Aedge90/Bierdeckel/presentation/abschussvortrag/vortrag.tex

\documentclass[aspectratio=43,t]{beamer}
%\documentclass[aspectratio=43,t,handout]{beamer}

\usepackage[ansinew]{inputenc}
\usepackage[T1]{fontenc}
\usepackage[english]{babel}
\usepackage{amsmath,amssymb}
\usepackage{graphicx}
\usepackage{listings}
\usepackage{verbatim}
\usepackage[backend=biber,sorting=ydnt,doi=true]{biblatex}
\usepackage{adjustbox}
\usepackage{subfigure}

\usepackage{wrapfig}
\usepackage{chngcntr}
\setbeamertemplate{caption}[numbered]
\usepackage{listings}

\usepackage{amssymb}% http://ctan.org/pkg/amssymb
\usepackage{pifont}% http://ctan.org/pkg/pifont
\newcommand{\cmark}{\ding{51}}%
\newcommand{\xmark}{\ding{55}}%

% Themes:
%  - fau:          Default FAU theme
%  - fau-tf:       TechFak FAU theme
%  - fau-tf-hscd:  Co-Design FAU theme
%
% Options:
%  - seal:         FAU seal on title page (default)
	%  - logo:         Beamer logo on all pages
	%  - image:        Cover image on title page
	%  - plain:        Plain title page
	%  - longtitle:    Title page layout for long title
	%  - dark:         Dark version of theme
	\usetheme[seal, longtitle]{fau-tf}
	%\setbeamercovered{transparent}

	\lstset{%
		language=C++,
			tabsize=2,
			basicstyle=\tt\scriptsize,
			keywordstyle=\color{blue},
			commentstyle=\color{green!50!black},
			stringstyle=\color{black},
			% stringstyle=\color{red},
			numbers=left,
			numbersep=0.5em,
			numberstyle=\tt\tiny
	}

\defbibheading{bibliography}{}
\addbibresource[label=primary]{references.bib}
\nocite{*}

% Title, authors, and date
\title[SmartBierdeggl]{SmartBierdeggl}
\subtitle{DIY: Abschlussvortrag}
\author[Achim Herrmann/Daeubler]{Achim Herrmann/Daeubler}
\institute[Rechnernetze und Kommunikationssysteme]{Rechnernetze und Kommunikationssysteme, Friedrich-Alexander-Universität Erlangen-Nürnberg}
\date{\today}

\begin{document}
% Title
\frame[plain,c,noframenumbering]{\titlepage}

\begin{frame}{Idee}
                \begin{center}
        \begin{adjustbox}{max width=.8\textwidth, max height=.8\textheight}
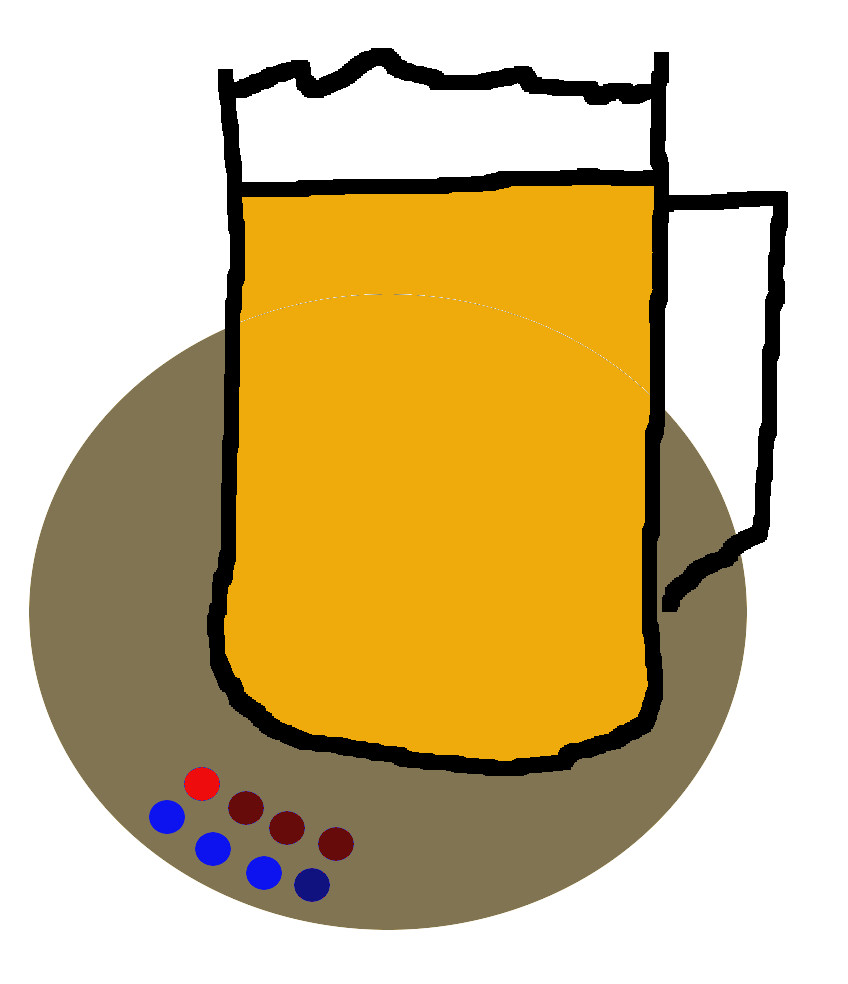
[picture p12: presentation/abschussvortrag/images/idee.jpg]
                        
%        \end{adjustbox}
%        \begin{adjustbox}{max width=.4\textwidth, max height=.4\textheight}
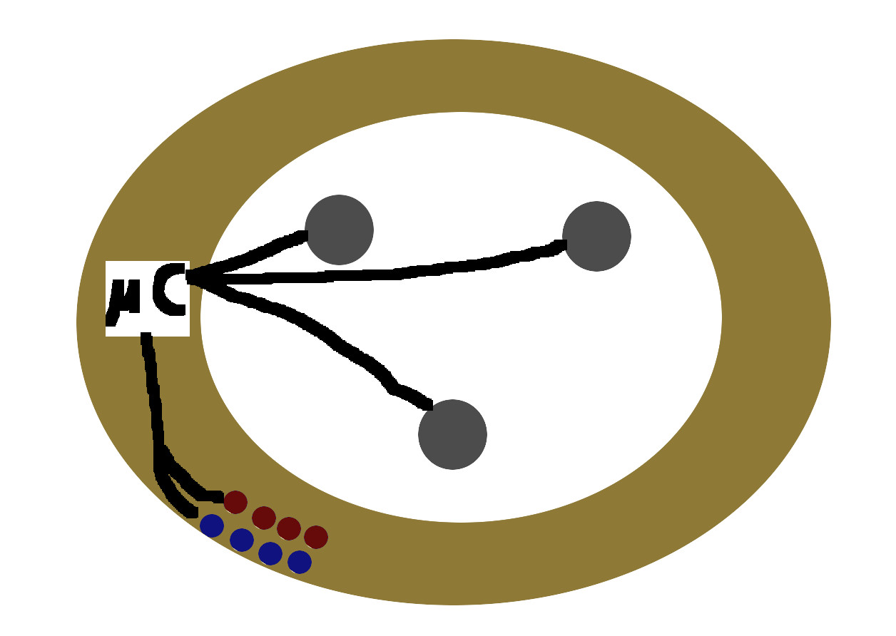
[picture p13: presentation/abschussvortrag/images/aufbau.jpg]
                        
        \end{adjustbox}
                \end{center}
\end{frame}
\begin{frame}{Aktueller Stand}
                \begin{center}
        \begin{adjustbox}{max width=.8\textwidth, max height=.8\textheight}
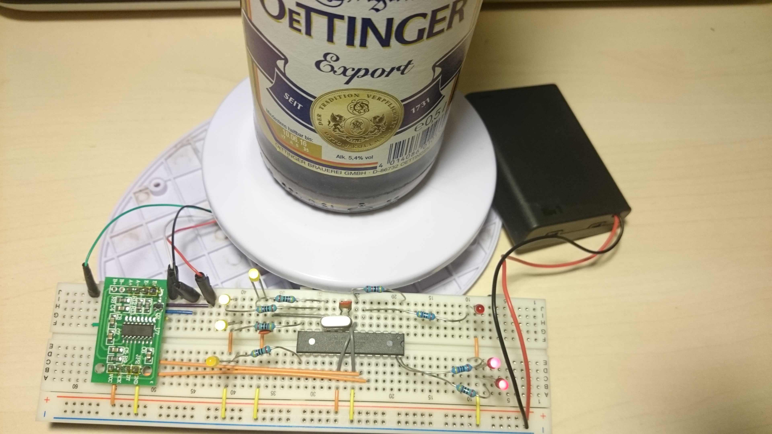
[picture p14: presentation/abschussvortrag/images/prototype.jpg]
                         %l b r u
        \end{adjustbox}
                \end{center}

\end{frame}
\begin{frame}{Wiegeeinheit}

        \begin{itemize}
        \item Wägezelle mit Dehnmessstreifen (Wheatstone'sche Brückenschaltung)
        	\begin{figure}
        	        \begin{adjustbox}{height=.3\textheight}
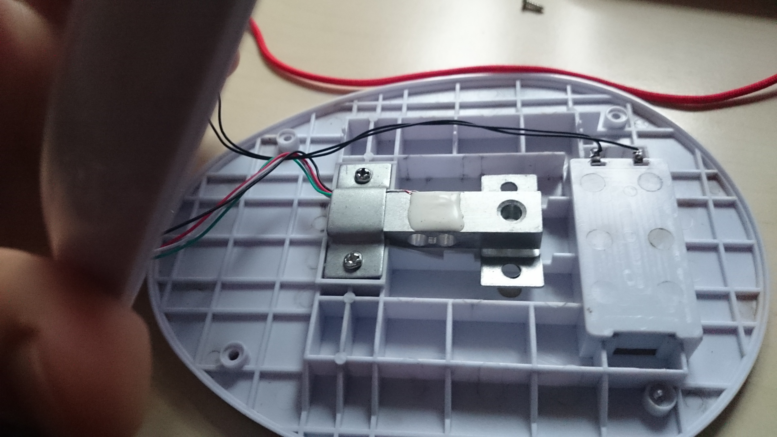
[picture p15: presentation/abschussvortrag/images/loadcell.jpg]
                         
        \end{adjustbox}
        	\end{figure}
        \item HX711: 24 bit ADC
        \begin{figure}
        	        \begin{adjustbox}{height=.3\textheight}
                        
        \end{adjustbox}
        \end{figure}
        \end{itemize}

\end{frame}

\begin{frame}{Schaltplan}
  \begin{adjustbox}{height=.9\textheight}
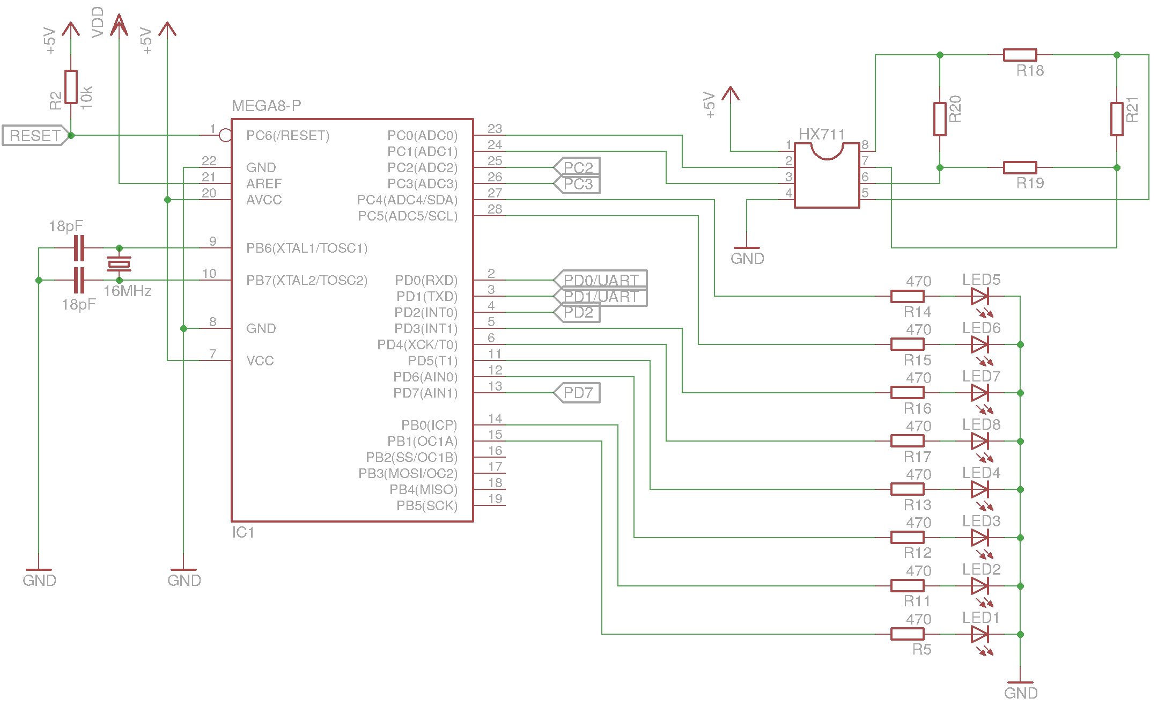
[picture p16: presentation/abschussvortrag/images/board_complete.png]
	
   \end{adjustbox}
\end{frame}

\begin{frame}
\lstinputlisting[]{code/main.c}
\end{frame}
\begin{frame}
\lstinputlisting[]{code/hx711.c}
\end{frame}

{ % Questions?
	\setbeamertemplate{footline}{}
	\begin{frame}[c,noframenumbering]
		\begin{center}
	Danke für ihre Aufmerksamkeit.\\
	{\bf Noch Fragen?}
	\end{center}
	\end{frame}
}
\end{document}
