Aedge90/Bierdeckel/presentation/vortrag/images/auto.jpg

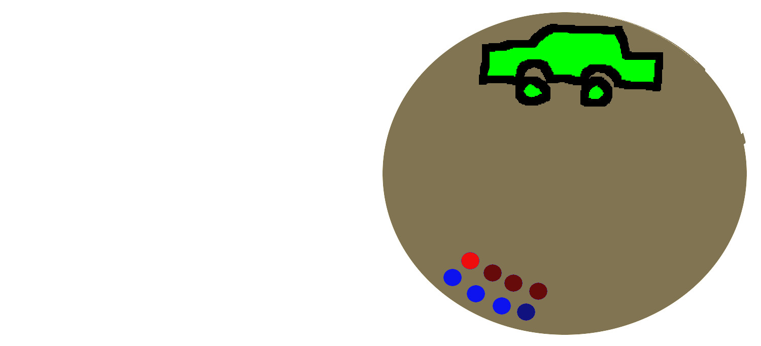
presentation/vortrag/images/auto.jpg
