Aedge90/Bierdeckel/presentation/vortrag/images/getraenke.jpg

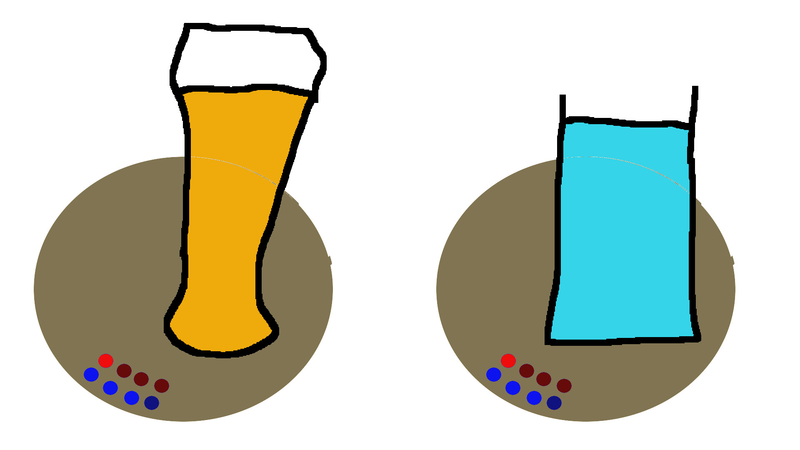
presentation/vortrag/images/getraenke.jpg
