Aedge90/Bierdeckel/presentation/vortrag/images/komm.jpg

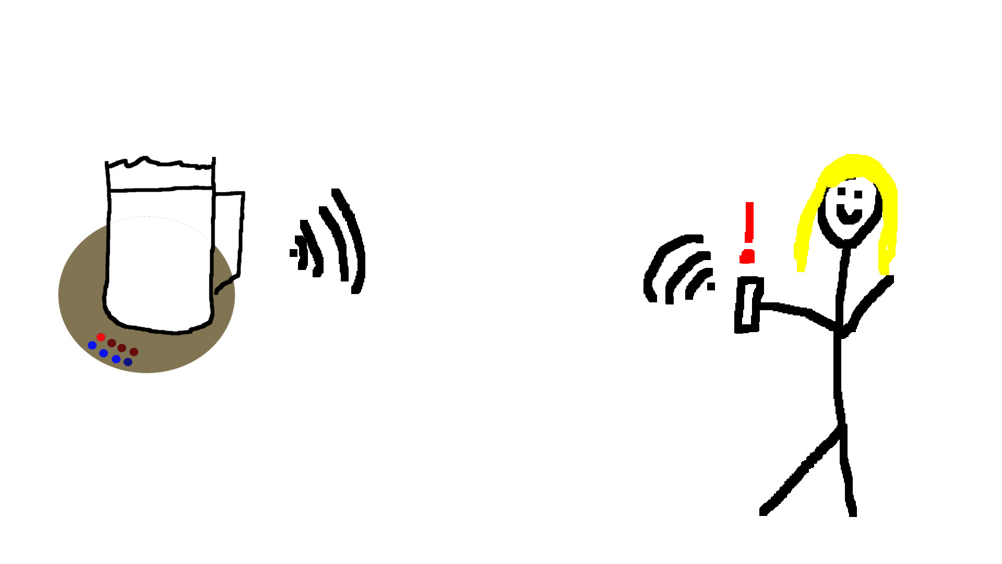
presentation/vortrag/images/komm.jpg
