Aedge90/Bierdeckel/presentation/vortrag/images/motivation.jpg

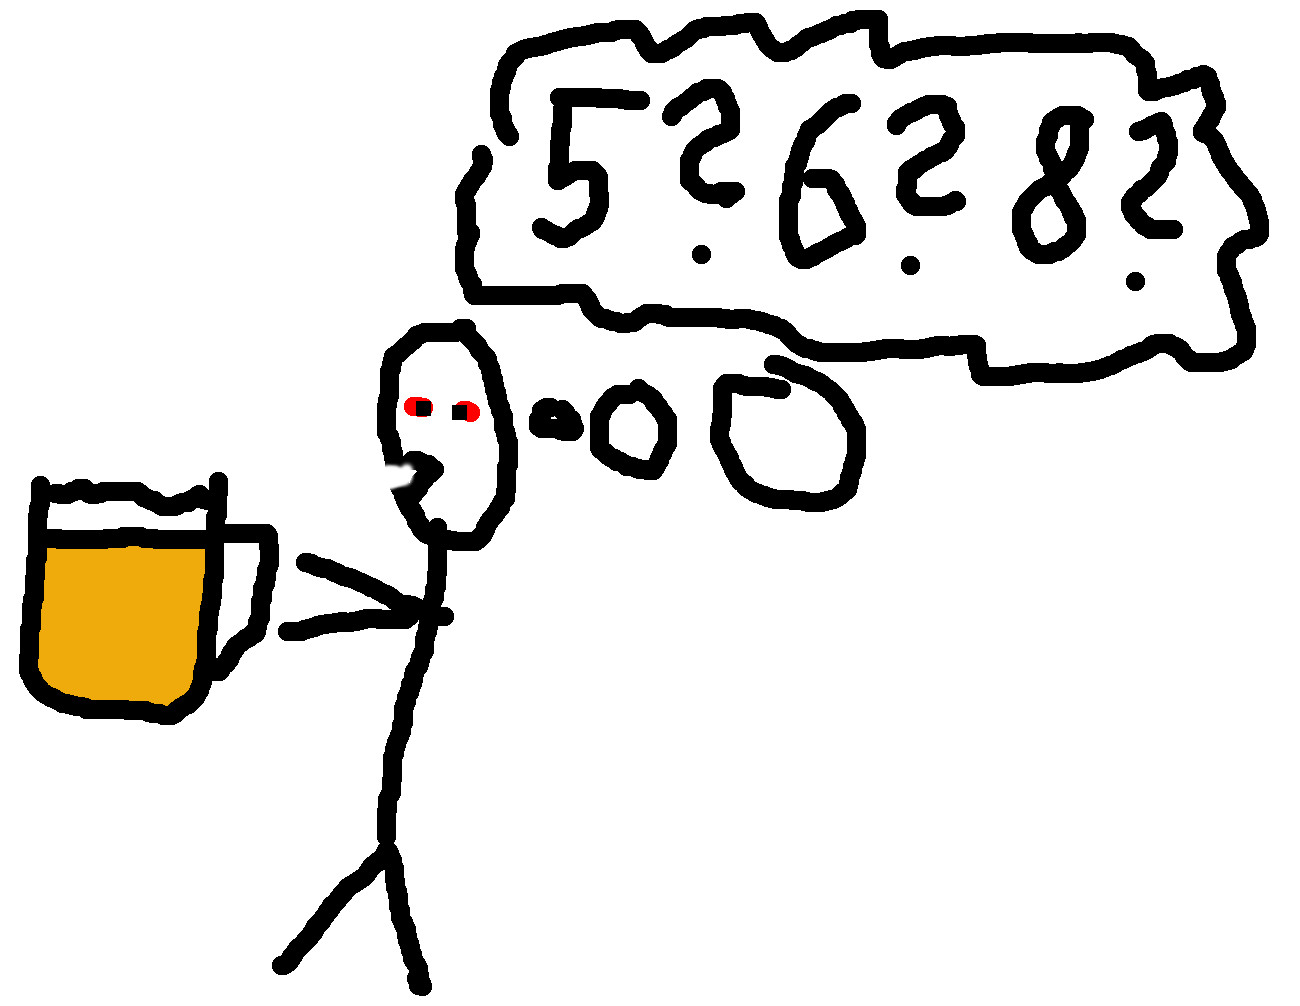
presentation/vortrag/images/motivation.jpg
