Aedge90/Bierdeckel/presentation/vortrag/images/vision.jpg

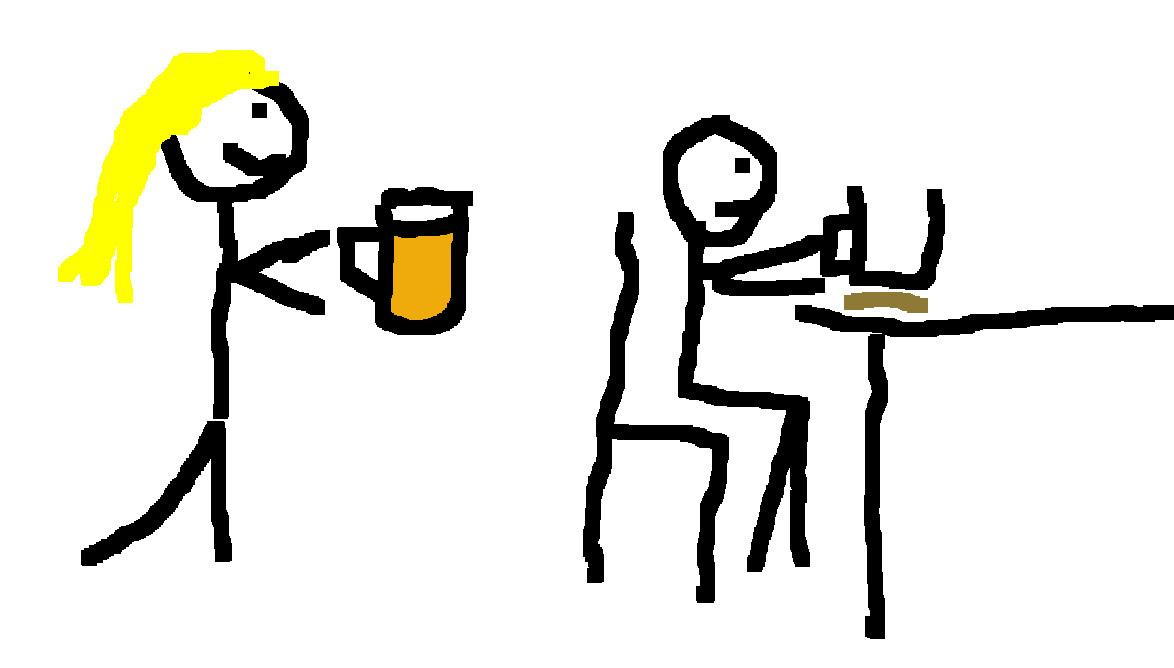
presentation/vortrag/images/vision.jpg
