Aedge90/Bierdeckel/(list of files, cad)

Other CAD files:
src/case/case.scad
