Aedge90/Bierdeckel/board/mc_board_with_leds.brd

## EAGLE design board/mc_board_with_leds.brd (2016-04-16)

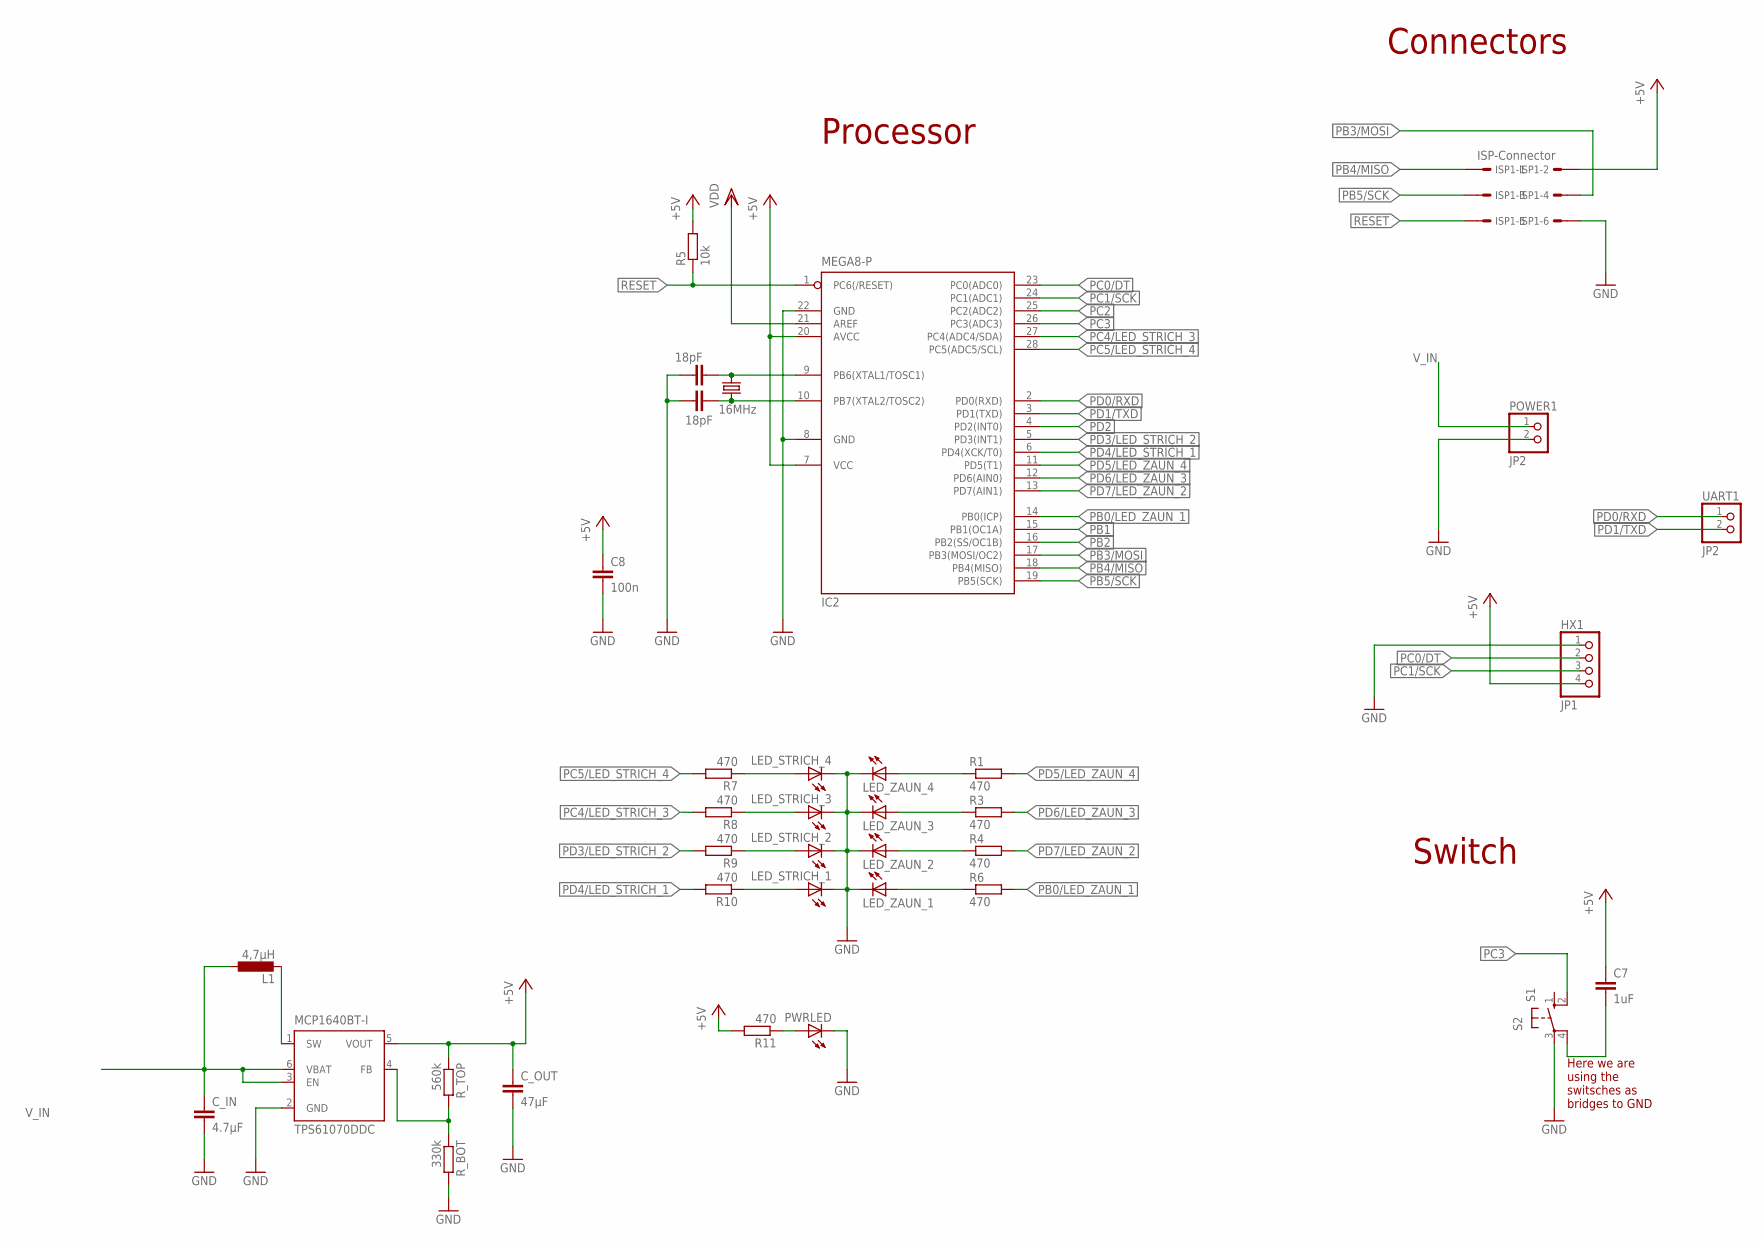
[picture p22: schematic mc_board_with_leds.sch]

Parts:
C5, C6: 18pF; C0805K
C7: 1uF; C0805
C8: 100n; C0805
C_IN: 4.7μF; C0805
C_OUT: 47μF; C0805
HX1: JP1; 1X04
IC2: MEGA8-P; DIL28-3
ISP1: ISP-Connector; 057-006-1
L1: 4,7µH; L4532P
LED_STRICH_1, LED_STRICH_2, LED_STRICH_3, LED_STRICH_4: LED3MM
LED_ZAUN_1, LED_ZAUN_2, LED_ZAUN_3, LED_ZAUN_4: LED3MM
MCP1640BT-I: TPS61070DDC; TSOT23-6_DDC
POWER1: JP2; 1X02
PWRLED: LED3MM
Q2: 16MHz; HC49/S
R1, R3, R4, R6, R7, R8, R9, R10, R11: 470; R0805
R5: 10k; R1206
R_BOT: 330k; R0805
R_TOP: 560k; R0805
S2: S1; B3F-10XX
UART1: JP2; 1X02

Connections:
+5V: C7.1, C8.1, C_OUT.1, HX1.4, IC2.7 (VCC), IC2.20 (AVCC), ISP1.2, MCP1640BT-I.5 (VOUT), R5.2, R11.2, R_TOP.1
GND: C5.2, C6.2, C8.2, C_IN.2, C_OUT.2, HX1.1, IC2.8 (GND), IC2.22 (GND), ISP1.6, LED_STRICH_1.K (C), LED_STRICH_2.K (C), LED_STRICH_3.K (C), LED_STRICH_4.K (C), LED_ZAUN_1.K (C), LED_ZAUN_2.K (C), LED_ZAUN_3.K (C), LED_ZAUN_4.K (C), MCP1640BT-I.2 (GND), POWER1.2, PWRLED.K (C), R_BOT.2, S2.3
unnamed: LED_ZAUN_4.A, R1.1
unnamed: LED_ZAUN_3.A, R3.1
unnamed: LED_ZAUN_2.A, R4.1
unnamed: C5.1, IC2.10 (PB7(XTAL2/TOSC2)), Q2.2
unnamed: L1.2, MCP1640BT-I.1 (SW)
unnamed: MCP1640BT-I.4 (FB), R_BOT.1, R_TOP.2
unnamed: LED_ZAUN_1.A, R6.1
unnamed: LED_STRICH_4.A, R7.1
unnamed: LED_STRICH_3.A, R8.1
unnamed: LED_STRICH_2.A, R9.1
unnamed: LED_STRICH_1.A, R10.1
unnamed: PWRLED.A, R11.1
unnamed: C6.1, IC2.9 (PB6(XTAL1/TOSC1)), Q2.1
unnamed: C7.2, S2.4 (P1)
PB0/LED_ZAUN_1: IC2.14 (PB0(ICP)), R6.2
PB1: IC2.15 (PB1(OC1A))
PB2: IC2.16 (PB2(SS/OC1B))
PB3/MOSI: IC2.17 (PB3(MOSI/OC2)), ISP1.4
PB4/MISO: IC2.18 (PB4(MISO)), ISP1.1
PB5/SCK: IC2.19 (PB5(SCK)), ISP1.3
PC0/DT: HX1.2, IC2.23 (PC0(ADC0))
PC1/SCK: HX1.3, IC2.24 (PC1(ADC1))
PC2: IC2.25 (PC2(ADC2))
PC3: IC2.26 (PC3(ADC3)), S2.2 (S1)
PC4/LED_STRICH_3: IC2.27 (PC4(ADC4/SDA)), R8.2
PC5/LED_STRICH_4: IC2.28 (PC5(ADC5/SCL)), R7.2
PD0/RXD: IC2.2 (PD0(RXD)), UART1.1
PD1/TXD: IC2.3 (PD1(TXD)), UART1.2
PD2: IC2.4 (PD2(INT0))
PD3/LED_STRICH_2: IC2.5 (PD3(INT1)), R9.2
PD4/LED_STRICH_1: IC2.6 (PD4(XCK/T0)), R10.2
PD5/LED_ZAUN_4: IC2.11 (PD5(T1)), R1.2
PD6/LED_ZAUN_3: IC2.12 (PD6(AIN0)), R3.2
PD7/LED_ZAUN_2: IC2.13 (PD7(AIN1)), R4.2
RESET: IC2.1 (PC6(/RESET)), ISP1.5, R5.1
VDD: IC2.21 (AREF)
V_IN: C_IN.1, L1.1, MCP1640BT-I.3 (EN), MCP1640BT-I.6 (VBAT), POWER1.1

Notes on the sheet:
Connectors
Switch
Processor
Here we are using the switsches as bridges to GND

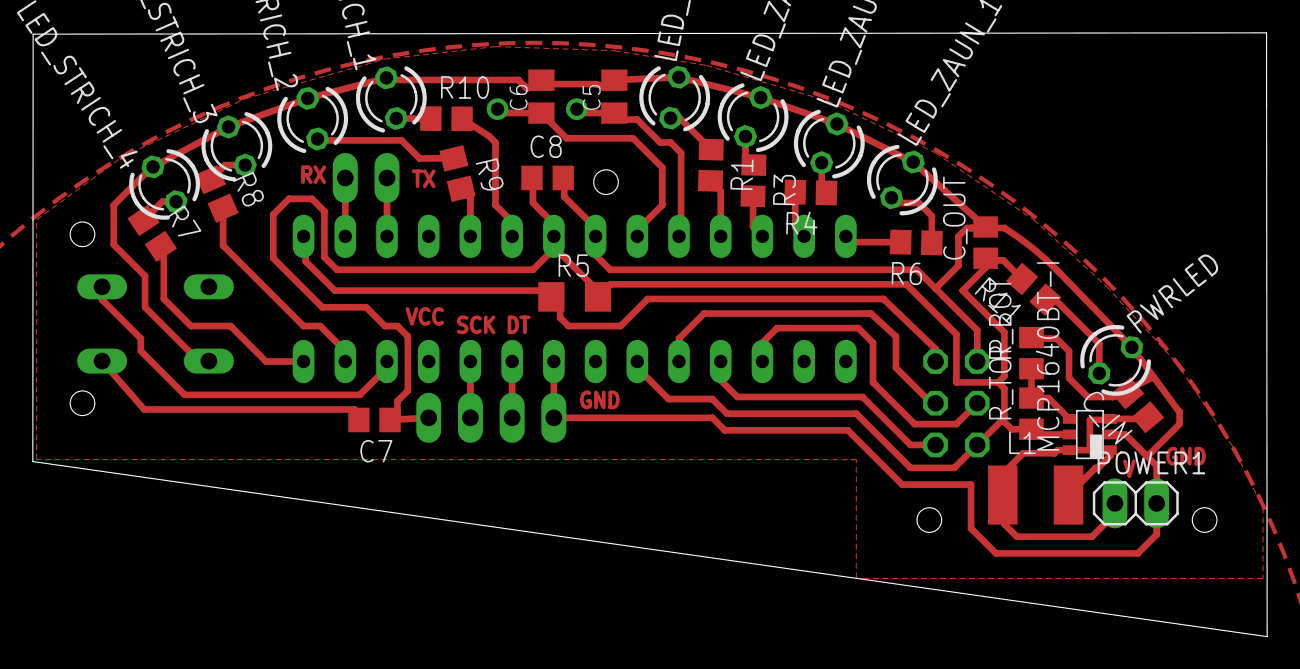
[picture p23: board mc_board_with_leds.brd from above]

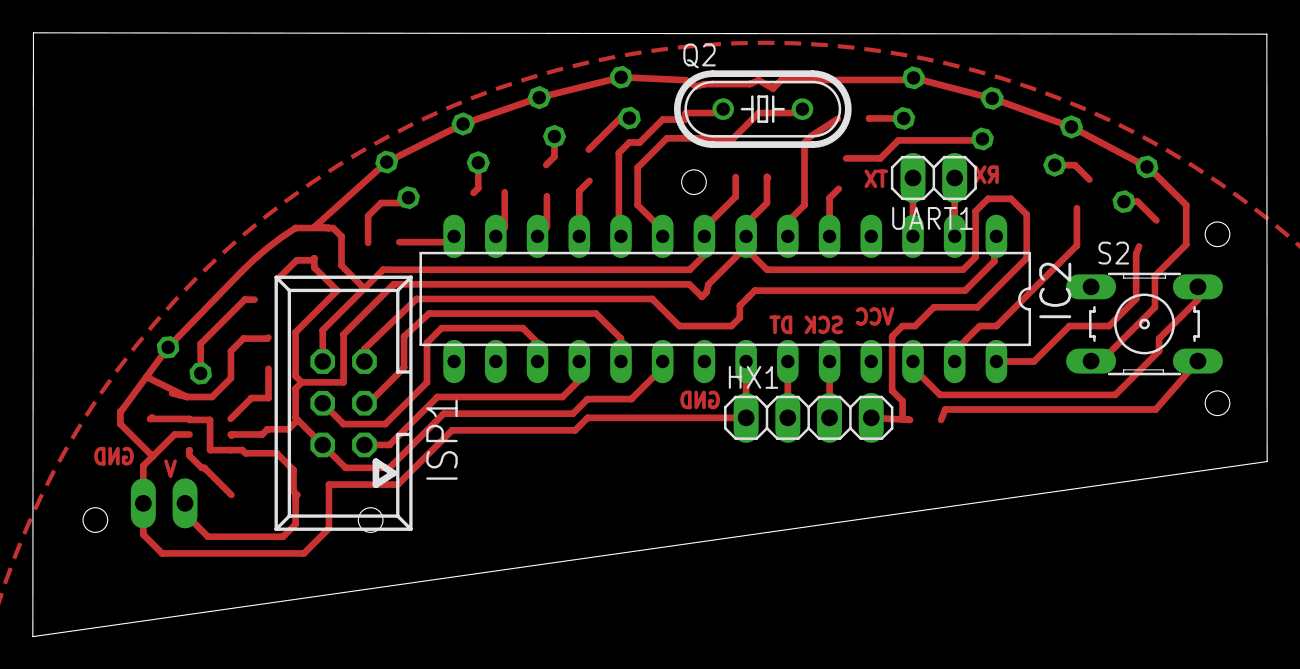
[picture p24: board mc_board_with_leds.brd from below]

Board: 2 copper layers, 75.2 x 36.8 mm, 36 parts (6 on the bottom side), 34 nets.
