Aedge90/Bierdeckel/board/mc_board.brd

## EAGLE design board/mc_board.brd (2016-02-11)

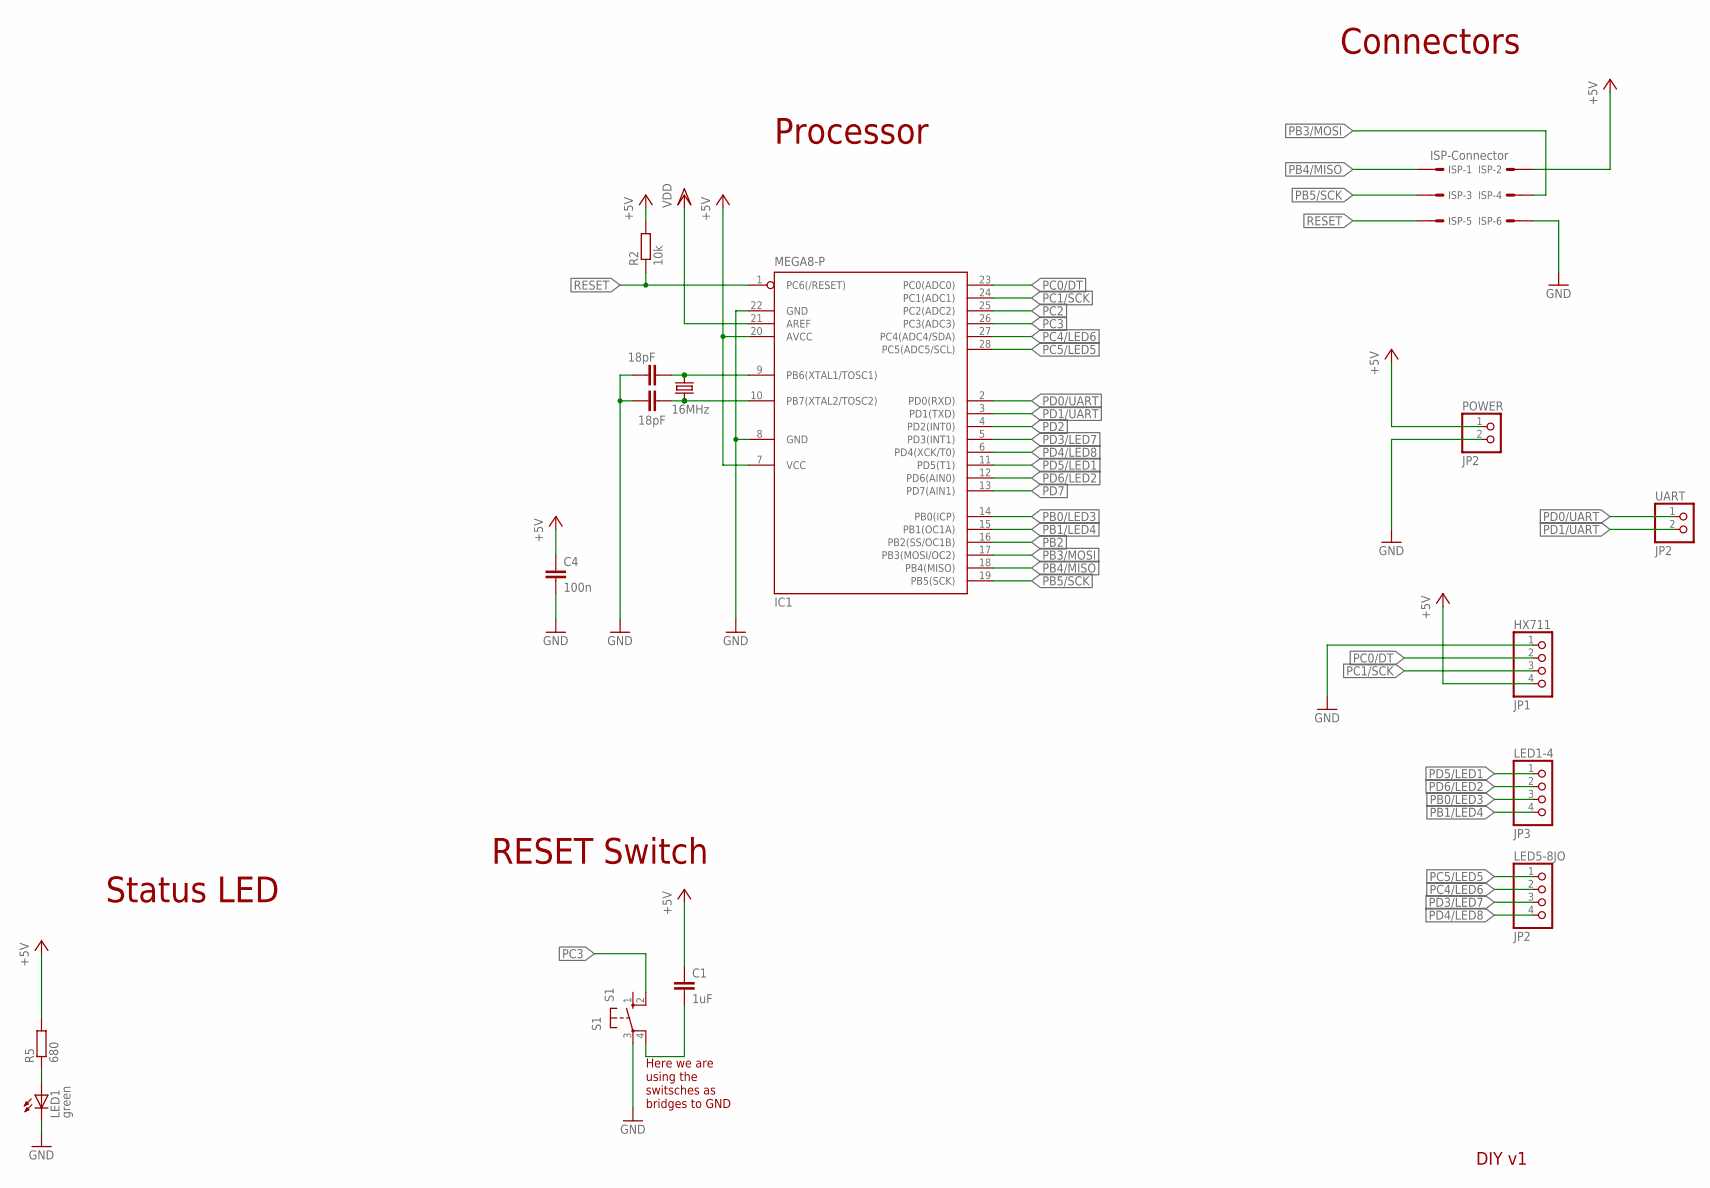
[picture p25: schematic mc_board.sch]

Parts:
C1: 1uF; C0805
C2, C3: 18pF; C0805K
C4: 100n; C0805
HX711: JP1; 1X04
IC1: MEGA8-P; DIL28-3
ISP: ISP-Connector; 057-006-1
LED1: green; CHIPLED_0805
LED1-4: JP3; 1X04
LED5-8JO: JP2; 1X04
POWER: JP2; 1X02
Q1: 16MHz; HC49/S
R2: 10k; R1206
R5: 680; R0805
S1: S1; B3F-10XX
UART: JP2; 1X02

Connections:
+5V: C1.1, C4.1, HX711.4, IC1.7 (VCC), IC1.20 (AVCC), ISP.2, POWER.1, R2.2, R5.2
GND: C2.2, C3.2, C4.2, HX711.1, IC1.8 (GND), IC1.22 (GND), ISP.6, LED1.C, POWER.2, S1.3
unnamed: LED1.A, R5.1
unnamed: C3.1, IC1.9 (PB6(XTAL1/TOSC1)), Q1.1
unnamed: C2.1, IC1.10 (PB7(XTAL2/TOSC2)), Q1.2
unnamed: C1.2, S1.4 (P1)
PB0/LED3: IC1.14 (PB0(ICP)), LED1-4.3
PB1/LED4: IC1.15 (PB1(OC1A)), LED1-4.4
PB2: IC1.16 (PB2(SS/OC1B))
PB3/MOSI: IC1.17 (PB3(MOSI/OC2)), ISP.4
PB4/MISO: IC1.18 (PB4(MISO)), ISP.1
PB5/SCK: IC1.19 (PB5(SCK)), ISP.3
PC0/DT: HX711.2, IC1.23 (PC0(ADC0))
PC1/SCK: HX711.3, IC1.24 (PC1(ADC1))
PC2: IC1.25 (PC2(ADC2))
PC3: IC1.26 (PC3(ADC3)), S1.2 (S1)
PC4/LED6: IC1.27 (PC4(ADC4/SDA)), LED5-8JO.2
PC5/LED5: IC1.28 (PC5(ADC5/SCL)), LED5-8JO.1
PD0/UART: IC1.2 (PD0(RXD)), UART.1
PD1/UART: IC1.3 (PD1(TXD)), UART.2
PD2: IC1.4 (PD2(INT0))
PD3/LED7: IC1.5 (PD3(INT1)), LED5-8JO.3
PD4/LED8: IC1.6 (PD4(XCK/T0)), LED5-8JO.4
PD5/LED1: IC1.11 (PD5(T1)), LED1-4.1
PD6/LED2: IC1.12 (PD6(AIN0)), LED1-4.2
PD7: IC1.13 (PD7(AIN1))
RESET: IC1.1 (PC6(/RESET)), ISP.5, R2.1
VDD: IC1.21 (AREF)

Notes on the sheet:
Status LED
Connectors
RESET Switch
DIY v1
Processor
Here we are using the switsches as bridges to GND

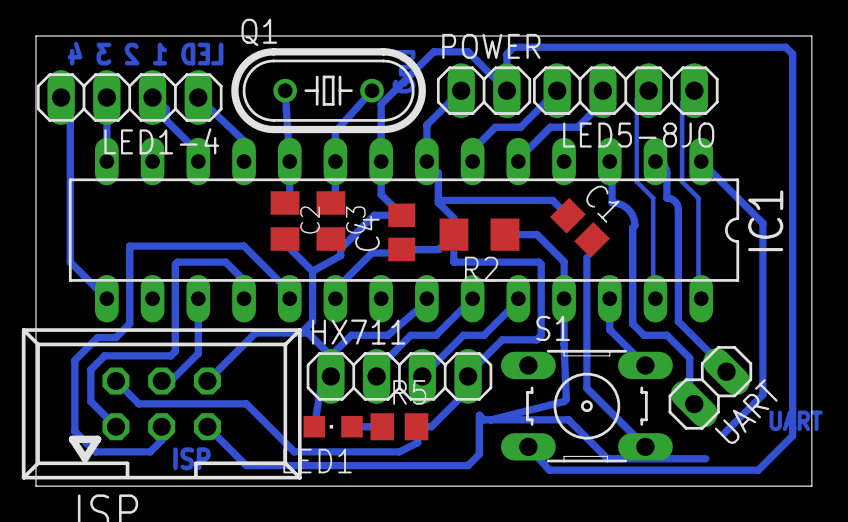
[picture p26: board mc_board.brd from above]

Board: 2 copper layers, 43.1 x 25.0 mm, 16 parts (0 on the bottom side), 23 nets.
