Aedge90/Bierdeckel/board/led_board_v2.brd

## EAGLE design board/led_board_v2.brd (2016-02-11)

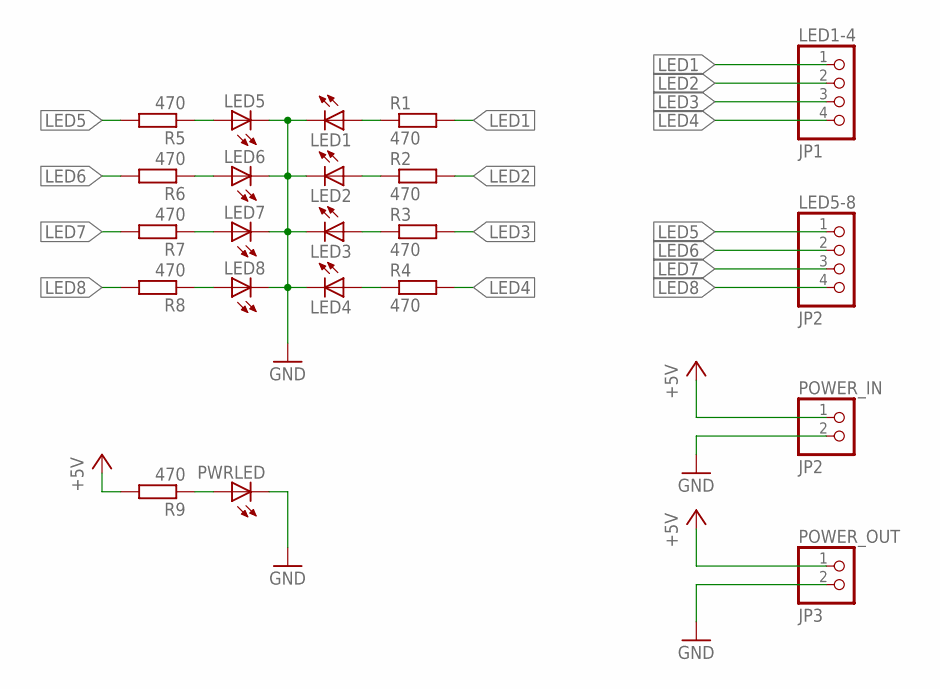
[picture p27: schematic led_board_v2.sch]

Parts:
LED1, LED2, LED3, LED4, LED5, LED6, LED7, LED8: LED3MM
LED1-4: JP1; 1X04
LED5-8: JP2; 1X04
POWER_IN: JP2; 1X02
POWER_OUT: JP3; 1X02
PWRLED: LED3MM
R1, R2, R3, R4, R5, R6, R7, R8, R9: 470; R0805

Connections:
+5V: POWER_IN.1, POWER_OUT.1, R9.2
GND: LED1.K (C), LED2.K (C), LED3.K (C), LED4.K (C), LED5.K (C), LED6.K (C), LED7.K (C), LED8.K (C), POWER_IN.2, POWER_OUT.2, PWRLED.K (C)
LED1: LED1-4.1, R1.2
LED2: LED1-4.2, R2.2
LED3: LED1-4.3, R3.2
LED4: LED1-4.4, R4.2
LED5: LED5-8.1, R5.2
LED6: LED5-8.2, R6.2
LED7: LED5-8.3, R7.2
LED8: LED5-8.4, R8.2
unnamed: LED1.A, R1.1
unnamed: LED2.A, R2.1
unnamed: LED3.A, R3.1
unnamed: LED4.A, R4.1
unnamed: LED5.A, R5.1
unnamed: LED6.A, R6.1
unnamed: LED7.A, R7.1
unnamed: LED8.A, R8.1
unnamed: PWRLED.A, R9.1

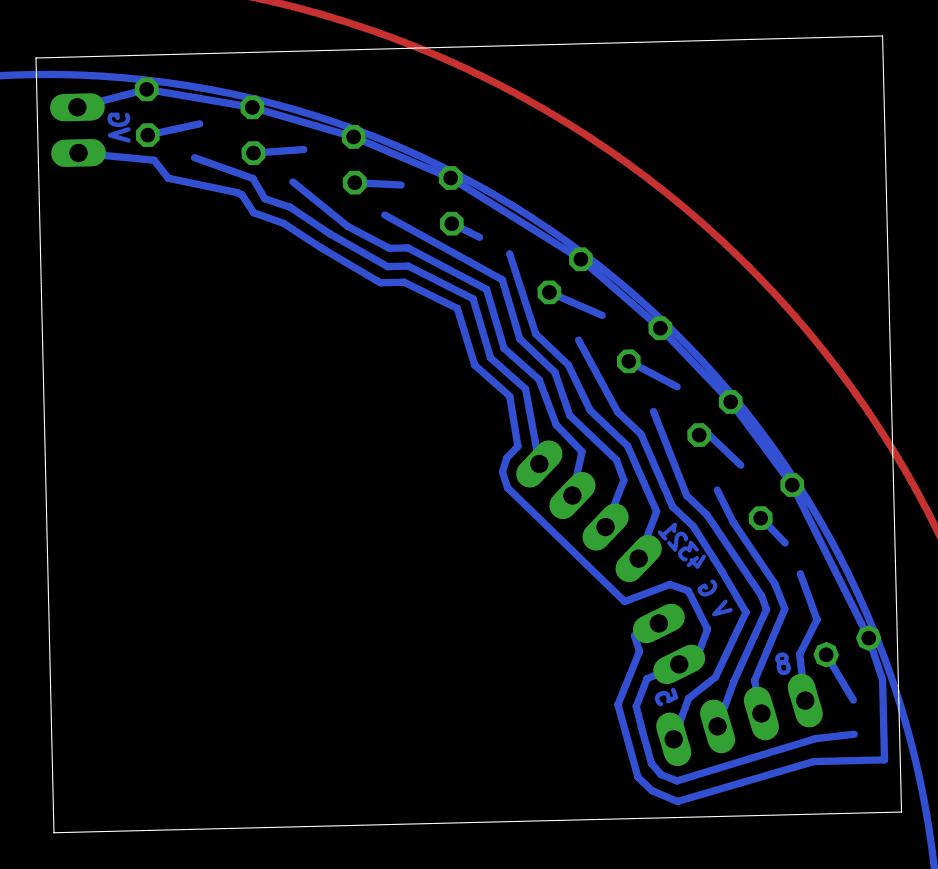
[picture p28: board led_board_v2.brd from above]

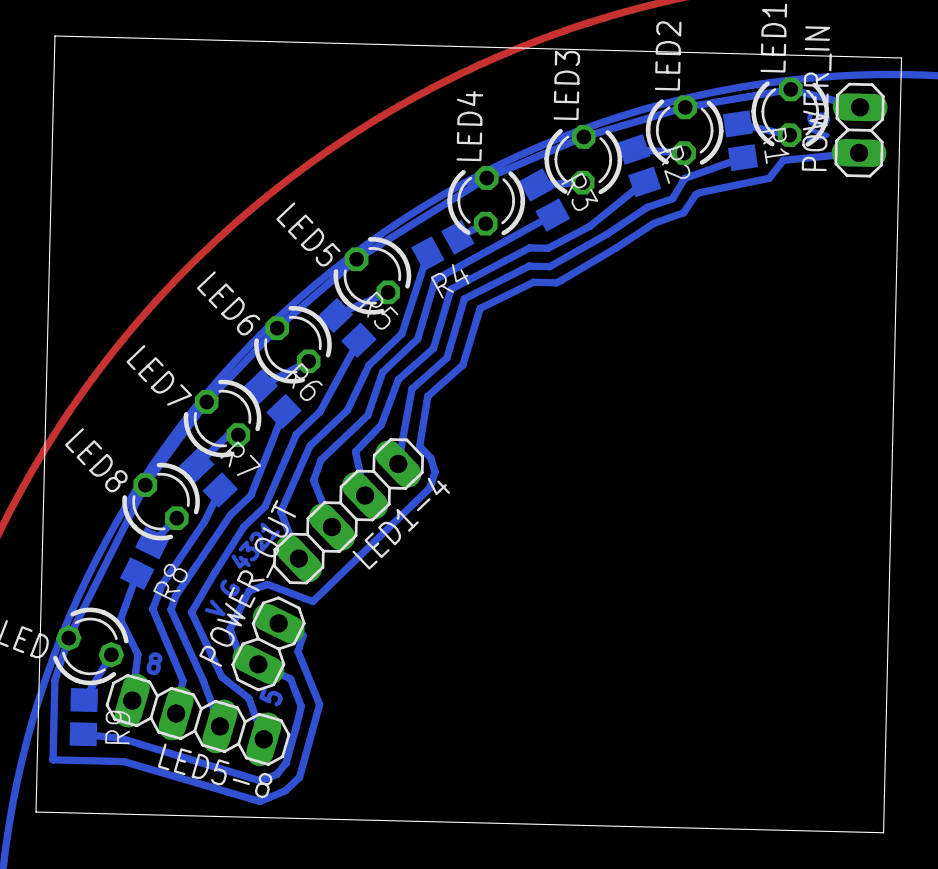
[picture p29: board led_board_v2.brd from below]

Board: 2 copper layers, 48.1 x 44.3 mm, 22 parts (22 on the bottom side), 19 nets.
