Aedge90/Bierdeckel/board/printversion.brd

## EAGLE design board/printversion.brd (2016-02-28)

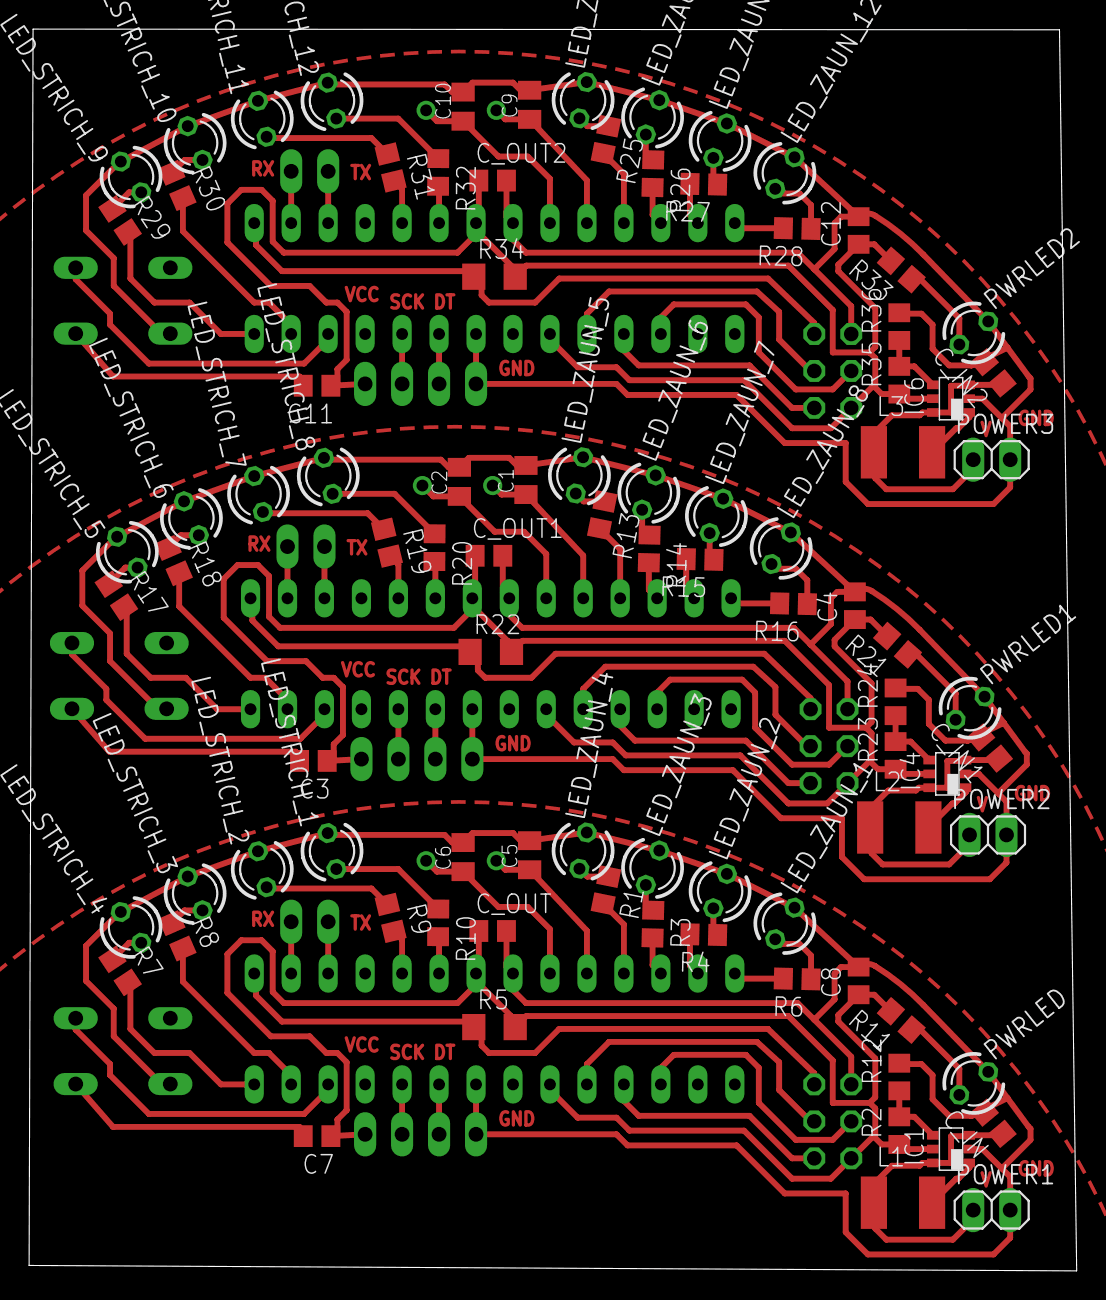
[picture p30: board printversion.brd from above]

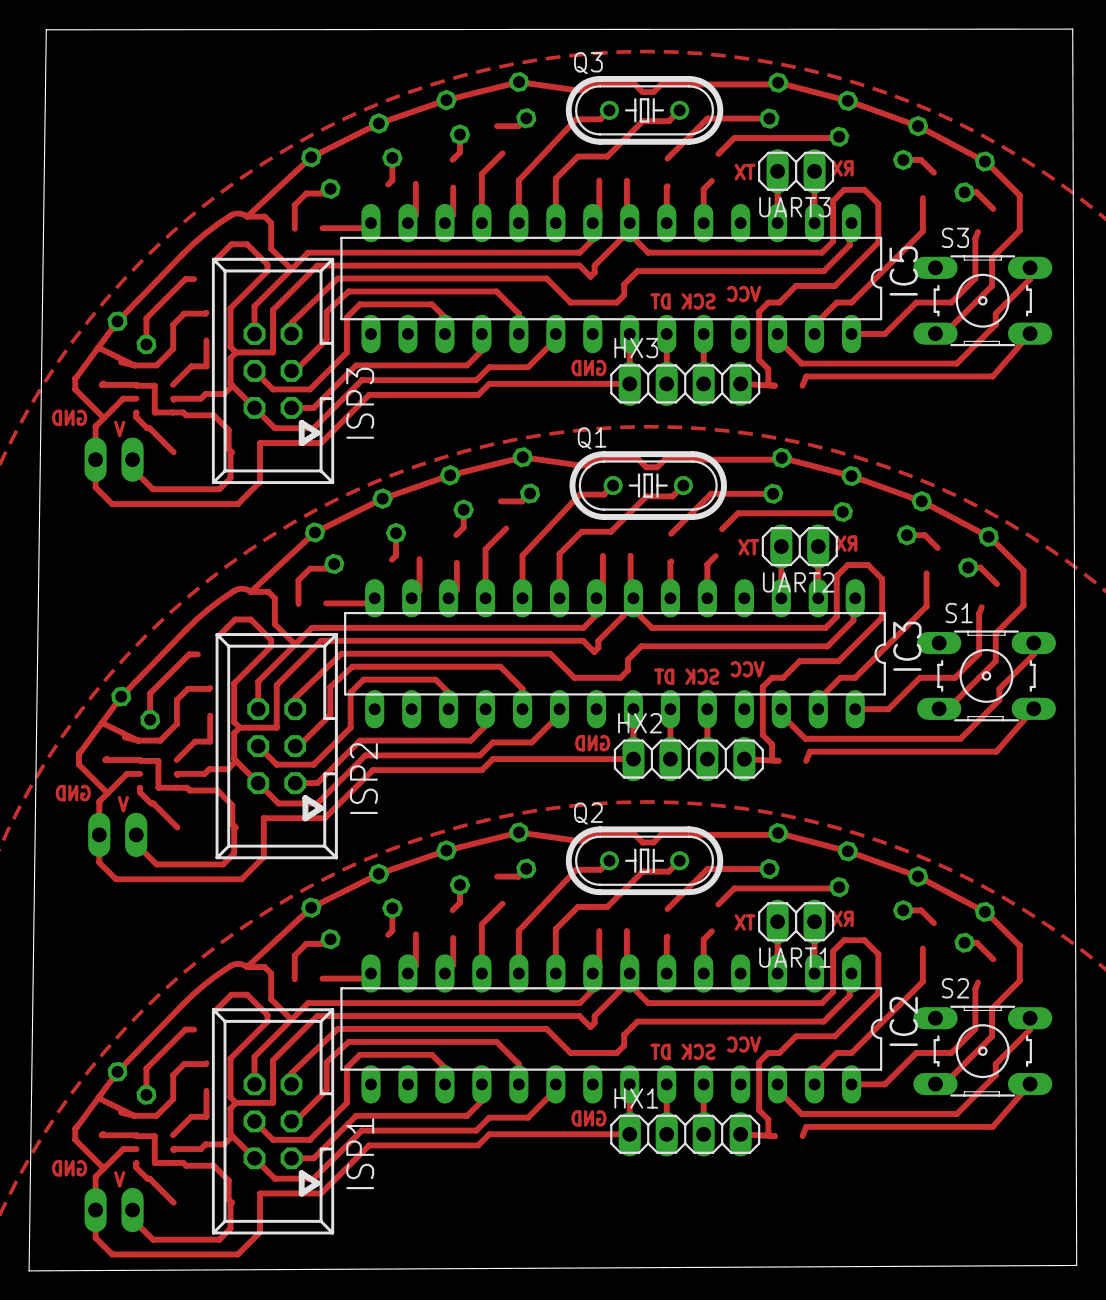
[picture p31: board printversion.brd from below]

Board: 2 copper layers, 72.0 x 85.3 mm, 108 parts (18 on the bottom side), 102 nets.

Parts:
C1, C2, C5, C6, C9, C10: 18pF; C0805K
C3, C7, C11: 1uF; C0805
C4, C8, C12: 100n; C0805
C_IN, C_IN1, C_IN2: C0805
C_OUT, C_OUT1, C_OUT2: C0805
HX1, HX2, HX3: JP1; 1X04
IC1, IC4, IC6: TPS61070DDC; TSOT23-6_DDC
IC2, IC3, IC5: MEGA8-P; DIL28-3
ISP1, ISP2, ISP3: ISP-Connector; 057-006-1
L1, L2, L3: L4532P
LED_STRICH_1, LED_STRICH_2, LED_STRICH_3, LED_STRICH_4, LED_STRICH_5, LED_STRICH_6, LED_STRICH_7, LED_STRICH_8, LED_STRICH_9, LED_STRICH_10, LED_STRICH_11, LED_STRICH_12: LED3MM
LED_ZAUN_1, LED_ZAUN_2, LED_ZAUN_3, LED_ZAUN_4, LED_ZAUN_5, LED_ZAUN_6, LED_ZAUN_7, LED_ZAUN_8, LED_ZAUN_9, LED_ZAUN_10, LED_ZAUN_11, LED_ZAUN_12: LED3MM
POWER1, POWER2, POWER3: JP2; 1X02
PWRLED, PWRLED1, PWRLED2: LED3MM
Q1, Q2, Q3: 16MHz; HC49/S
R1, R3, R4, R6, R7, R8, R9, R10, R11, R13, R14, R15, R16, R17, R18, R19, R20, R21, R25, R26, R27, R28, R29, R30, R31, R32, R33: 470; R0805
R2, R12, R23, R24, R35, R36: R0805
R5, R22, R34: 10k; R1206
S1, S2, S3: S1; B3F-10XX
UART1, UART2, UART3: JP2; 1X02

Connections:
+5V: C7.1, C8.1, C_OUT.1, HX1.4, IC1.5, IC2.7, IC2.20, ISP1.2, R2.1, R5.2, R11.2
+5V1: C3.1, C4.1, C_OUT1.1, HX2.4, IC3.7, IC3.20, IC4.5, ISP2.2, R21.2, R22.2, R23.1
+5V2: C11.1, C12.1, C_OUT2.1, HX3.4, IC5.7, IC5.20, IC6.5, ISP3.2, R33.2, R34.2, R35.1
GND: C5.2, C6.2, C8.2, C_IN.2, C_OUT.2, HX1.1, IC1.2, IC2.8, IC2.22, ISP1.6, LED_STRICH_1.K, LED_STRICH_2.K, LED_STRICH_3.K, LED_STRICH_4.K, LED_ZAUN_1.K, LED_ZAUN_2.K, LED_ZAUN_3.K, LED_ZAUN_4.K, POWER1.2, PWRLED.K, R12.2, S2.3
GND1: C1.2, C2.2, C4.2, C_IN1.2, C_OUT1.2, HX2.1, IC3.8, IC3.22, IC4.2, ISP2.6, LED_STRICH_5.K, LED_STRICH_6.K, LED_STRICH_7.K, LED_STRICH_8.K, LED_ZAUN_5.K, LED_ZAUN_6.K, LED_ZAUN_7.K, LED_ZAUN_8.K, POWER2.2, PWRLED1.K, R24.2, S1.3
GND2: C9.2, C10.2, C12.2, C_IN2.2, C_OUT2.2, HX3.1, IC5.8, IC5.22, IC6.2, ISP3.6, LED_STRICH_9.K, LED_STRICH_10.K, LED_STRICH_11.K, LED_STRICH_12.K, LED_ZAUN_9.K, LED_ZAUN_10.K, LED_ZAUN_11.K, LED_ZAUN_12.K, POWER3.2, PWRLED2.K, R36.2, S3.3
unnamed: LED_ZAUN_4.A, R1.1
unnamed: LED_ZAUN_3.A, R3.1
unnamed: LED_ZAUN_2.A, R4.1
unnamed: C5.1, IC2.10, Q2.2
unnamed: IC1.1, L1.2
unnamed: IC1.4, R2.2, R12.1
unnamed: LED_ZAUN_1.A, R6.1
unnamed: LED_STRICH_4.A, R7.1
unnamed: LED_STRICH_3.A, R8.1
unnamed: LED_STRICH_2.A, R9.1
unnamed: LED_STRICH_1.A, R10.1
unnamed: PWRLED.A, R11.1
unnamed: C6.1, IC2.9, Q2.1
unnamed: C7.2, S2.4
unnamed: LED_ZAUN_5.A, R13.1
unnamed: LED_ZAUN_6.A, R14.1
unnamed: LED_ZAUN_7.A, R15.1
unnamed: LED_ZAUN_8.A, R16.1
unnamed: LED_STRICH_5.A, R17.1
unnamed: LED_STRICH_6.A, R18.1
unnamed: LED_STRICH_7.A, R19.1
unnamed: LED_STRICH_8.A, R20.1
unnamed: PWRLED1.A, R21.1
unnamed: C1.1, IC3.10, Q1.2
unnamed: C2.1, IC3.9, Q1.1
unnamed: C3.2, S1.4
unnamed: IC4.1, L2.2
unnamed: IC4.4, R23.2, R24.1
unnamed: LED_ZAUN_9.A, R25.1
unnamed: LED_ZAUN_10.A, R26.1
unnamed: LED_ZAUN_11.A, R27.1
unnamed: LED_ZAUN_12.A, R28.1
unnamed: LED_STRICH_9.A, R29.1
unnamed: LED_STRICH_10.A, R30.1
unnamed: LED_STRICH_11.A, R31.1
unnamed: LED_STRICH_12.A, R32.1
unnamed: PWRLED2.A, R33.1
unnamed: C9.1, IC5.10, Q3.2
unnamed: C10.1, IC5.9, Q3.1
unnamed: C11.2, S3.4
unnamed: IC6.1, L3.2
unnamed: IC6.4, R35.2, R36.1
PB0/LED_ZAUN_1: IC2.14, R6.2
PB0/LED_ZAUN_2: IC3.14, R16.2
PB0/LED_ZAUN_3: IC5.14, R28.2
PB3/MOSI: IC2.17, ISP1.4
PB3/MOSI1: IC3.17, ISP2.4
PB3/MOSI2: IC5.17, ISP3.4
PB4/MISO: IC2.18, ISP1.1
PB4/MISO1: IC3.18, ISP2.1
PB4/MISO2: IC5.18, ISP3.1
PB5/SCK: IC2.19, ISP1.3
PB5/SCK1: IC3.19, ISP2.3
PB5/SCK2: IC5.19, ISP3.3
PC0/DT: HX1.2, IC2.23
PC0/DT1: HX2.2, IC3.23
PC0/DT2: HX3.2, IC5.23
PC1/SCK: HX1.3, IC2.24
PC1/SCK1: HX2.3, IC3.24
PC1/SCK2: HX3.3, IC5.24
PC3: IC2.26, S2.2
PC4: IC3.26, S1.2
PC4/LED_STRICH_1: IC3.27, R18.2
PC4/LED_STRICH_2: IC5.27, R30.2
PC4/LED_STRICH_3: IC2.27, R8.2
PC5/LED_STRICH_1: IC3.28, R17.2
PC5/LED_STRICH_2: IC5.28, R29.2
PC5/LED_STRICH_4: IC2.28, R7.2
PC6: IC5.26, S3.2
PD0/RXD: IC2.2, UART1.1
PD0/RXD1: IC3.2, UART2.1
PD0/RXD2: IC5.2, UART3.1
PD1/TXD: IC2.3, UART1.2
PD1/TXD1: IC3.3, UART2.2
PD1/TXD2: IC5.3, UART3.2
PD3/LED_STRICH_1: IC3.5, R19.2
PD3/LED_STRICH_2: IC2.5, R9.2
PD3/LED_STRICH_3: IC5.5, R31.2
PD4/LED_STRICH_1: IC2.6, R10.2
PD4/LED_STRICH_2: IC3.6, R20.2
PD4/LED_STRICH_3: IC5.6, R32.2
PD5/LED_ZAUN_1: IC3.11, R13.2
PD5/LED_ZAUN_2: IC5.11, R25.2
PD5/LED_ZAUN_4: IC2.11, R1.2
PD6/LED_ZAUN_1: IC3.12, R14.2
PD6/LED_ZAUN_2: IC5.12, R26.2
PD6/LED_ZAUN_3: IC2.12, R3.2
PD7/LED_ZAUN_1: IC3.13, R15.2
PD7/LED_ZAUN_2: IC2.13, R4.2
PD7/LED_ZAUN_3: IC5.13, R27.2
RESET: IC2.1, ISP1.5, R5.1
RESET1: IC3.1, ISP2.5, R22.1
RESET2: IC5.1, ISP3.5, R34.1
V_IN: C_IN.1, IC1.3, IC1.6, L1.1, POWER1.1
V_IN1: C_IN1.1, IC4.3, IC4.6, L2.1, POWER2.1
V_IN2: C_IN2.1, IC6.3, IC6.6, L3.1, POWER3.1
