Aedge90/Bierdeckel/src/app/bierdeggl_tinyusbboard/usbprint.h

#ifndef __USB_PRINT_H__
#define __USB_PRINT_H__

#include <avr/io.h> 
#include <avr/wdt.h>
#include <avr/eeprom.h>
#include <avr/interrupt.h>
#include <avr/pgmspace.h>
#include <util/delay.h>
#include "keymap.h"

#ifndef uchar
#define uchar unsigned char
#endif

#define BIT_LED 0
//#define BIT_KEY 3

#define UTIL_BIN4(x)        (uchar)((0##x & 01000)/64 + (0##x & 0100)/16 + (0##x & 010)/4 + (0##x & 1))
#define UTIL_BIN8(hi, lo)   (uchar)(UTIL_BIN4(hi) * 16 + UTIL_BIN4(lo))

#ifndef NULL
#define NULL    ((void *)0)
#endif


/* Keyboard usage values, see usb.org's HID-usage-tables document, chapter
 * 10 Keyboard/Keypad Page for more codes.
 */
#define MOD_CONTROL_LEFT    (1<<0)
#define MOD_SHIFT_LEFT      (1<<1)
#define MOD_ALT_LEFT        (1<<2)
#define MOD_GUI_LEFT        (1<<3)
#define MOD_CONTROL_RIGHT   (1<<4)
#define MOD_SHIFT_RIGHT     (1<<5)
#define MOD_ALT_RIGHT       (1<<6)
#define MOD_GUI_RIGHT       (1<<7)

#define KEY_1       30
#define KEY_2       31
#define KEY_3       32
#define KEY_4       33
#define KEY_5       34
#define KEY_6       35
#define KEY_7       36
#define KEY_8       37
#define KEY_9       38
#define KEY_0       39
#define KEY_RETURN  40

void putChar(char c);
void putInt(int32_t value);
void putString(char *str);
void usbprint_setup(void);
void usbprint_flush(void);


/* ------------------------------------------------------------------------- */
/* ------------------------ interface to USB driver ------------------------ */
/* ------------------------------------------------------------------------- */

uchar	usbFunctionSetup(uchar data[8]);
void    usbEventResetReady(void);

#endif
