Aedge90/Bierdeckel/(commit log)

2015-12-08 Initial design
    [case.scad]
2016-01-28 Changed permissions due to move to ntfs part
    [case.scad]
2016-01-29 added led board and mc board layouts
    [led_board.brd, led_board.sch, mc_board.brd, mc_board.sch]
2016-01-31 Arduino Bierdeggl Application
    working!!
2016-02-01 Implemented Application with UART, without Arduino IDE
2016-02-01 Refactored LED
2016-02-02 Extended Makefile for Arduino as ISP
    Bugfix in led.c: PC6/RST was LED Pin -> changed to PC4
    [led.c, main.c]
2016-02-02 added UART pins to layout
    [mc_board.brd, mc_board.sch]
2016-02-03 tweaked board layout, defined pins in led.c accordingly
    [led_board.brd, mc_board.brd, mc_board.sch]
2016-02-03 added values to resistors on led board
    [led_board.brd, led_board.sch]
2016-02-03 Working on a ntfs partition is a very bad idea...
    [led_board.brd, led_board.sch, mc_board.brd, mc_board.sch]
2016-02-04 Added prevention for false indication
    [main.c]
2016-02-04 added complete board image
2016-02-05 Kraut und Rüben
2016-02-10 improved board layout
    [mc_board.brd, mc_board.sch]
2016-02-10 even better board layout
    [mc_board.brd]
2016-02-11 new idea for led board layout
    [led_board_v2.brd, led_board_v2.sch]
2016-02-11 fixed led board layout v2
    [led_board_v2.brd]
2016-02-11 removed gnd pin form board
    [mc_board.brd, mc_board.sch]
2016-02-11 changed reset button to normal button
    [mc_board.brd, mc_board.sch]
2016-02-11 started to swap layer to bottom. not done!
    [led_board_v2.brd, mc_board.brd]
2016-02-18 added new version of case
    [case_v2.scad]
2016-02-18 fixed non manifold error
    [case_v2.scad]
2016-02-18 added padding
    [case_v2.scad]
2016-02-19 added filler
    [case_v2.scad]
2016-02-19 added colors and Bounding Boxes
    [case_v2.scad]
2016-02-19 added last Bounding Box
    [case_v2.scad]
2016-02-19 fixed something and reordered code
    [case_v2.scad]
2016-02-19 fixed BoardBB and tweaked layout
    [case_v2.scad]
2016-02-22 added leds to board
    [case_v2.scad]
2016-02-22 fixed bug and updated BoardBB
    [case_v2.scad]
2016-02-22 added new board version with leds
    [mc_board_with_leds.brd, mc_board_with_leds.sch]
2016-02-22 board finished
    [mc_board_with_leds.brd]
2016-02-22 changed code to match pin layout
2016-02-22 renamed LEDs in .c file and schematic
    [mc_board_with_leds.brd, mc_board_with_leds.sch]
2016-02-22 reordered leds
    [mc_board_with_leds.brd, mc_board_with_leds.sch]
2016-02-22 increased thickness
    [case_v2.scad]
2016-02-23 leds now seperate
    [case_v2.scad]
2016-02-23 modeled an led
    [case_v2.scad]
2016-02-23 fixed problems with Fill()
    [case_v2.scad]
2016-02-23 fixed led hole height
    [case_v2.scad]
2016-02-23 fixed coloring
    [case_v2.scad]
2016-02-23 better led model
    [case_v2.scad]
2016-02-24 small changes
    [mc_board_with_leds.brd]
2016-02-24 added step up converter to schematic
    [mc_board_with_leds.brd, mc_board_with_leds.sch]
2016-02-25 led board and case now match exactly
    [case_v2.scad, mc_board_with_leds.brd]
2016-02-25 integrated pull up into board layout
    [mc_board_with_leds.brd]
2016-02-26 added names to board
    [mc_board_with_leds.brd]
2016-02-26 changed names and corrected pin assignment of hx711
    [hx711.c, hx711.h]
2016-02-26 added drill holes
    [mc_board_with_leds.brd]
2016-02-26 added ground fill
    [mc_board_with_leds.brd]
2016-02-26 fixed it
    [mc_board_with_leds.brd]
2016-02-26 printable version
    [mc_board_with_leds.brd]
2016-02-28 added printversion with multiple boards per page
    [printversion.brd]
2016-03-12 all standard layer now visible again
    [mc_board_with_leds.brd]
2016-04-16 replaced some things on the board
    [mc_board_with_leds.brd]
2016-04-16 added missing values
    [mc_board_with_leds.brd, mc_board_with_leds.sch]
